WildUhr/WildUhr-ESP32/KiCad/WildClock/WildClock.kicad_pcb

## KiCad design KiCad/WildClock/WildClock.kicad_pcb (2023-03-27, last stored version)

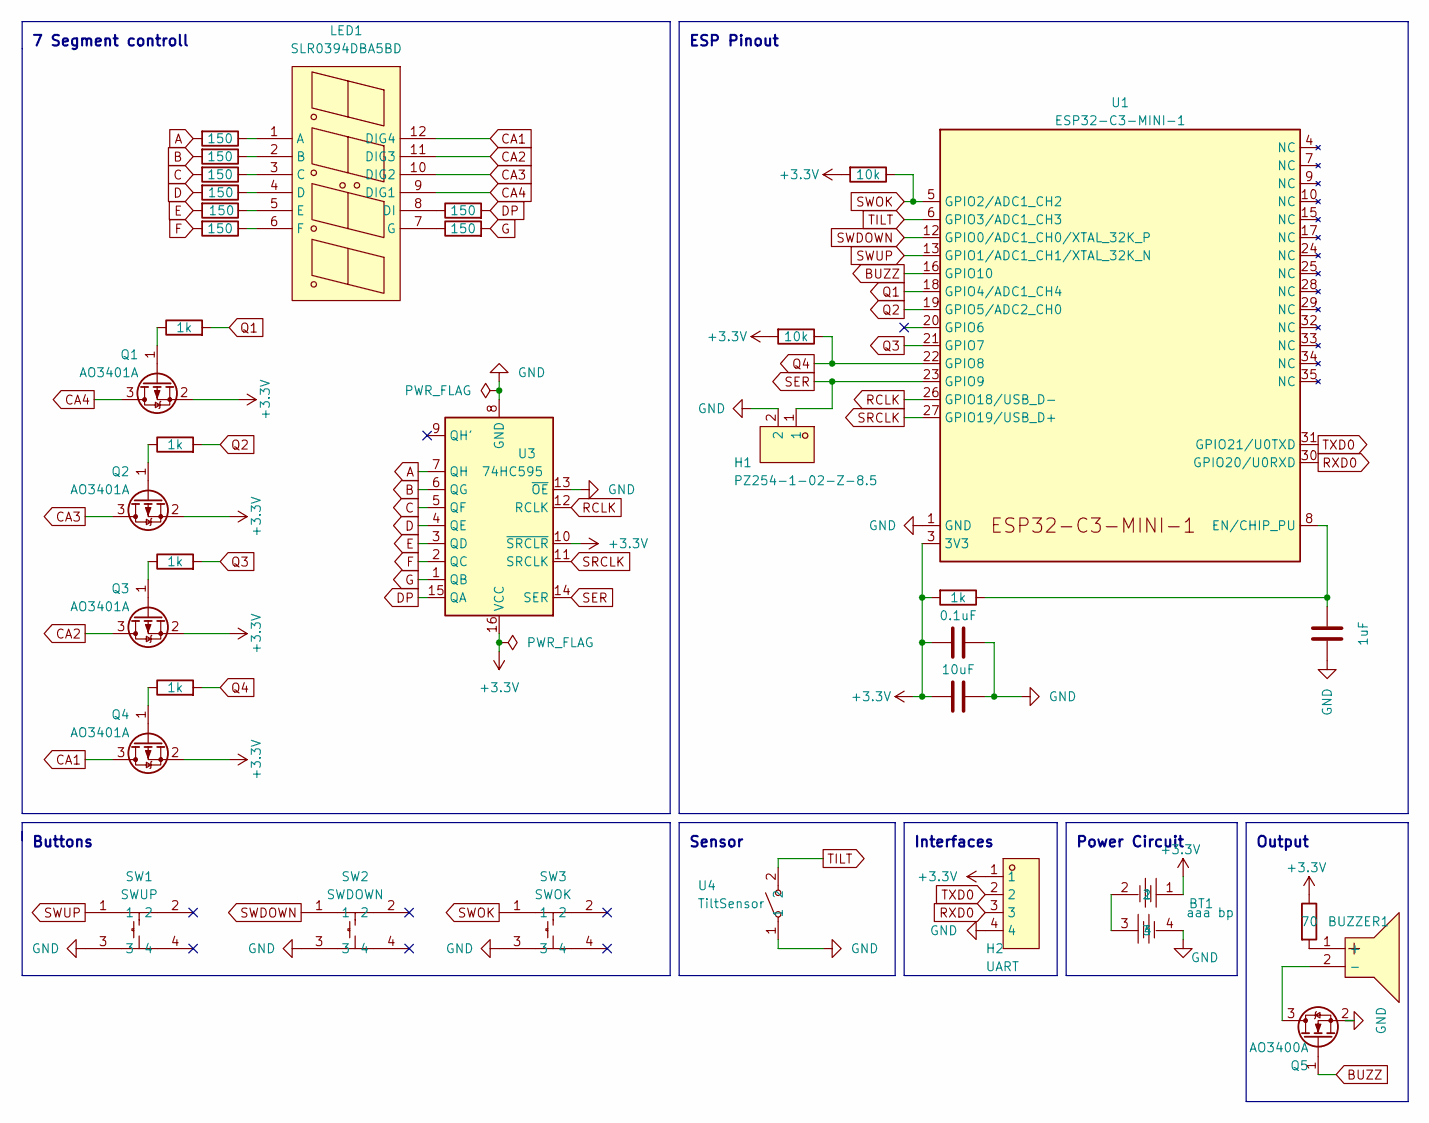
[picture p1: schematic WildClock.kicad_sch]

Parts:
BT1: aaa bp; BAT-SMD_BH-AAA-B5AA001; LCSC Part C964881
BUZZER1: GMC1209YB-25R2048; BUZ-TH_BD12.0-P6.50-D0.6-FD; LCSC Part C252921
C1: 10uF; C_0805_2012Metric
C2: 0.1uF; C_0805_2012Metric
C3: 1uF; C_0805_2012Metric
H1: PZ254-1-02-Z-8.5; HDR-TH_2P-P2.54-V-M; LCSC Part C2894925
H2: UART; HDR-TH_4P-P2.54-V-M; LCSC Part C2894927
LED1: SLR0394DBA5BD; LED-SEG-TH_SLR0394DBA5BD; LCSC Part C225903
Q1, Q2, Q3, Q4: AO3401A; SOT-23
Q5: AO3400A; SOT-23
R1, R3, R4, R5, R15: 1k; R_0805_2012Metric
R2: 70; R_0805_2012Metric
R6, R16: 10k; R_0805_2012Metric
R7, R8, R9, R10, R11, R12, R13, R14: 150; R_0805_2012Metric
SW1: SWUP; SW-TH_4P-L6.0-W6.0-P4.50-LS6.5; LCSC Part C455102
SW2: SWDOWN; SW-TH_4P-L6.0-W6.0-P4.50-LS6.5; LCSC Part C455102
SW3: SWOK; SW-TH_4P-L6.0-W6.0-P4.50-LS6.5; LCSC Part C455102
U1: ESP32-C3-MINI-1
U3: 74HC595; SOIC-16_L9.9-W3.9-P1.27-LS6.0-BL
U4: TiltSensor; SENSOR-TH_SW-520DS-AB12G; LCSC Part C2905288

Connections:
+3.3V: BT1.1, C1.2, C2.2, H2.1, Q1.2 (S), Q2.2 (S), Q3.2 (S), Q4.2 (S), R2.1, R6.2, R15.2, R16.2, U1.3 (3V3), U3.10 (~SRCLR), U3.16 (VCC)
A: R7.2, U3.7 (QH)
B: R8.2, U3.6 (QG)
BUZZ: Q5.1 (G), U1.16 (GPIO10)
C: R9.2, U3.5 (QF)
CA1: LED1.12 (DIG4), Q4.3 (D)
CA2: LED1.11 (DIG3), Q3.3 (D)
CA3: LED1.10 (DIG2), Q2.3 (D)
CA4: LED1.9 (DIG1), Q1.3 (D)
D: R10.2, U3.4 (QE)
DP: R14.2, U3.15 (QA)
E: R11.2, U3.3 (QD)
F: R12.2, U3.2 (QC)
G: R13.2, U3.1 (QB)
GND: BT1.4, C1.1, C2.1, C3.1, H1.2, H2.4, Q5.2 (S), SW1.3, SW2.3, SW3.3, U1.1 (GND), U1.2 (GND), U1.36 (GND), U1.37 (GND), U1.38 (GND), U1.39 (GND), U1.40 (GND), U1.41 (GND), U1.42 (GND), U1.43 (GND), U1.44 (GND), U1.45 (GND), U1.46 (GND), U1.47 (GND), U1.48 (GND), U1.49 (GND), U1.50 (GND), U1.51 (GND), U1.52 (GND), U1.53 (GND), U3.8 (GND), U3.13 (~OE), U4.1
unnamed: BT1.2, BT1.3
unnamed: BUZZER1.1 (+), R2.2
unnamed: BUZZER1.2 (-), Q5.3 (D)
unnamed: LED1.1 (A), R7.1
unnamed: LED1.2 (B), R8.1
unnamed: LED1.3 (C), R9.1
unnamed: LED1.4 (D), R10.1
unnamed: LED1.8 (DI), R14.1
unnamed: LED1.5 (E), R11.1
unnamed: LED1.6 (F), R12.1
unnamed: LED1.7 (G), R13.1
unnamed: Q1.1 (G), R1.1
unnamed: Q2.1 (G), R3.1
unnamed: Q3.1 (G), R4.1
unnamed: Q4.1 (G), R5.1
unnamed: C3.2, R15.1, U1.8 (EN/CHIP_PU)
Q1: R1.2, U1.18 (GPIO4/ADC1_CH4)
Q2: R3.2, U1.19 (GPIO5/ADC2_CH0)
Q3: R4.2, U1.21 (GPIO7)
Q4: R5.2, R6.1, U1.22 (GPIO8)
RCLK: U1.26 (GPIO18/USB_D-), U3.12 (RCLK)
RXD0: H2.3, U1.30 (GPIO20/U0RXD)
SER: H1.1, U1.23 (GPIO9), U3.14 (SER)
SRCLK: U1.27 (GPIO19/USB_D+), U3.11 (SRCLK)
SWDOWN: SW2.1, U1.12 (GPIO0/ADC1_CH0/XTAL_32K_P)
SWOK: R16.1, SW3.1, U1.5 (GPIO2/ADC1_CH2)
SWUP: SW1.1, U1.13 (GPIO1/ADC1_CH1/XTAL_32K_N)
TILT: U1.6 (GPIO3/ADC1_CH3), U4.2
TXD0: H2.2, U1.31 (GPIO21/U0TXD)

Notes on the sheet:
ESP Pinout
Power Circuit
Buttons
7 Segment controll
Output
Interfaces
Sensor

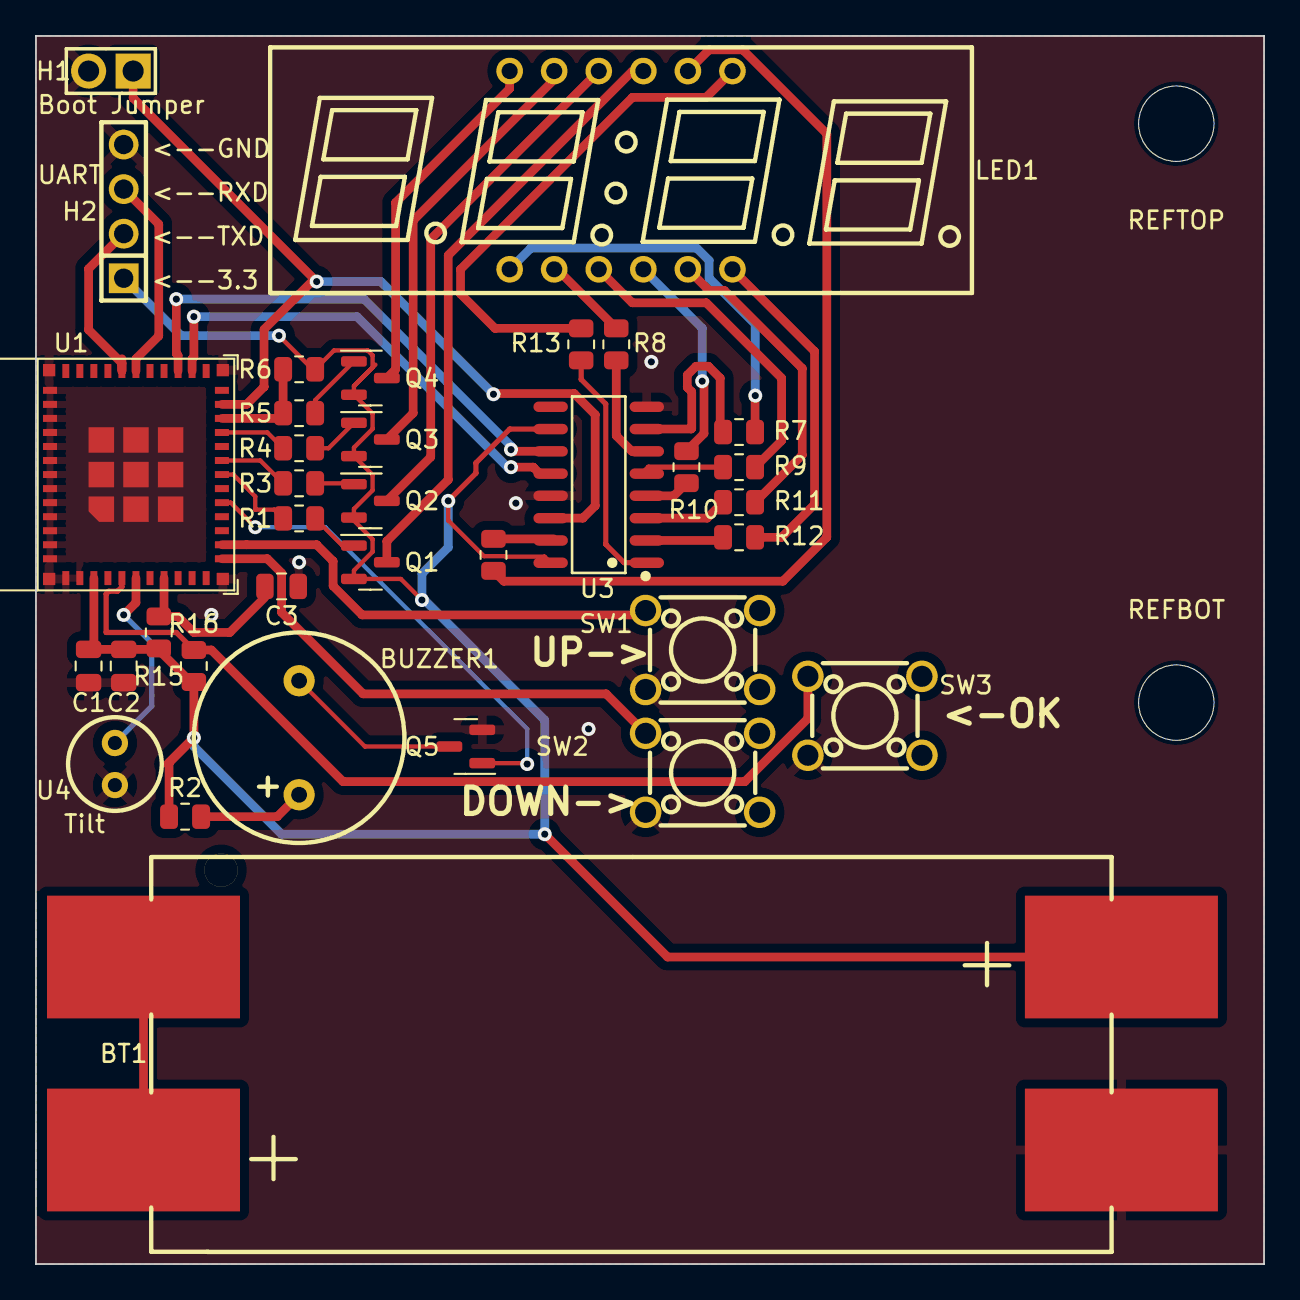
[picture p2: board WildClock.kicad_pcb from above]

Board: 2 copper layers, 70.0 x 70.0 mm, 37 parts (0 on the bottom side), 44 nets.

Other parts of the board:
REFBOT: MountingHole_4.3mm_M4
REFTOP: MountingHole_4.3mm_M4
