WildUhr/WildUhr-ESP32/(commit log)

2023-01-17 remove all prints and switch to logging
2023-02-21 added kicad files
    [WildClock.kicad_pcb, WildClock.kicad_sch]
2023-02-22 make all clearer and neu pcb
    [WildClock.kicad_pcb, WildClock.kicad_sch]
2023-02-23 changed some footprints
    [WildClock.kicad_pcb, WildClock.kicad_sch]
2023-02-27 start updating footprints to match jlcpcb
    [WildClock.kicad_pcb, WildClock.kicad_sch]
2023-03-04 use lcsc footprints
    [WildClock.kicad_pcb, WildClock.kicad_sch]
2023-03-27 implemented maxis changes
    [WildClock.kicad_pcb, WildClock.kicad_sch]
2023-03-27 added lables and move everything closer together
    [WildClock.kicad_pcb]
2023-03-27 fix batterie orientation
    [WildClock.kicad_pcb, WildClock.kicad_sch]
2023-09-22 remove kicad files
    [WildClock.kicad_pcb, WildClock.kicad_sch]
2023-09-23 remove kicad from gitignore
2023-09-29 first button draft
2023-10-03 add kernel and button debounce
2023-10-03 arm and navigate controll
2023-10-07 not working armed
    [partitions.csv]
2023-10-10 fliped tilt sensor and fixed deep sleep and nvs state recovery
    [ButtonControl.h, RealTimeClock.cpp, RealTimeClock.h, SegmentDriver.cpp, SleepControl.cpp]
2023-10-12 quick fix button bug
    [ButtonControl.cpp, ButtonControl.h]
2023-10-12 massive code cleanup and watchdog fix
    [ButtonControl.cpp, ButtonControl.h]
2023-10-16 add button sleep
2023-10-18 fix wait wake up
    [ButtonControl.cpp]
